pradeepa-s/temperature_logger/README.md

# Temperature Logger

A temperature logger project to start learning fundamentals of product design.

# Tests

## Behavioral

Behavioural tests are implemented for the design and they can be found in tests/behavior folder.

### Setup

1. Install Python 3.6 or above
1. Install behave
1. Install ST-LINK-CLI (comes with STLink utility)
1. Ensure that the ST-LINK-CLI is in the path

### How to run tests?

Run all the tests:

```
behave
```

Run a test with tag @test_tag:

```
behave -t @test_tag
```
