pradeepa-s/temperature_logger/planning/t_logger_v1.md

# Product capabilities

# Product limitations

1. Cannot go into lowest power modes due to the PCBA limitation of not using the wakeup pin
1. Cannot detect low battery
1. Cannot detect or wake up from USB
1. Cannot read from a given address
1. Cannot find out last write address and count
