pradeepa-s/temperature_logger/hardware/altium/temperature_logger/output/BOM/Bill of Materials-temperature_logger.xlsx

Comment | Description | Designator | Digikey_link | Footprint | LibRef | Manufacturer | Manufacturer Part Number | Quantity
 | Header, 2-Pin | BAT, BOOT, USB_POW |  | HDR1X2 | Header 2 |  |  | 3
47 pF | CAP CER 47PF 1KV C0G/NP0 0805 | C100, C101, C211 | https://www.digikey.com.au/product-detail/en/kemet/C0805C470JDGACTU/399-7157-1-ND/3439404 | C0805 | Cap-47pF | KEMET | C0805C470JDGACTU | 3
10 nF | CAP CER 10000PF 10V X7R 0805 | C102, C106 | https://www.digikey.com.au/product-detail/en/wurth-electronics-inc/885012207011/732-8021-1-ND/5454648 | C0805 | Cap-10nF | Wurth Electronics Inc. | 885012207011 | 2
100 nF | CAP CER 0.1UF 50V X7R 0805 | C103, C209 | https://www.digikey.com.au/product-detail/en/kemet/C0805X104K5RACTU/399-5330-1-ND/1842309 | C0805 | Cap-100nF | KEMET | C0805X104K5RACTU | 2
1000 pF | CAP CER 1000PF 100V X7R 0805 | C200, C201, C202, C203, C204, C205, C206, C207, C208, C210 | https://www.digikey.com.au/product-detail/en/kemet/C0805C102K1RACTU/399-1148-2-ND/411147 | C0805 | Cap-1000pF | KEMET | C0805C102K1RACTU | 10
LGR971 | LED GREEN DIFFUSED 0805 SMD | D200 | https://www.digikey.com.au/product-detail/en/osram-opto-semiconductors-inc/LG-R971-KN-1/475-1410-2-ND/1227925 | D0805 | LGR971 | Osram Opto | LG R971-KN-1 | 1
USB_Micro_B | USB - micro B USB 2.0 Receptacle Connector 5 Position Surface Mount, Right Angle; Through Hole | J100 | https://www.digikey.com.au/product-detail/en/te-connectivity-amp-connectors/2040002-1/A108263CT-ND/4021990 | MicroUSB | USB_Micro_B | TE Connectivity | 2040002-1 | 1
MicroSD | MICRO SD PUSH PUSH LOW PROFILE TYPE | J200 | https://www.digikey.com.au/product-detail/en/te-connectivity-amp-connectors/2201778-1/A118117CT-ND/4729820 | MicroSD | MicroSD | TE Connectivity | 2201778-1 | 1
 | Header, 5-Pin | JTAG |  | HDR1X5 | Header 5 |  |  | 1
5 k | RES SMD 4.7K OHM 0.1% 1/8W 0805 | R200, R201, R202 | https://www.digikey.com.au/product-detail/en/panasonic-electronic-components/ERA-6AEB472V/P4.7KDACT-ND/1465963 | R0805 | Res-5k | Panasonic Electronic Components | ERA-6AEB472V | 3
1 k | RES 1K OHM 0.1% 1/5W 0805 | R203, R204, R205, R206, R208, R211 | https://www.digikey.com.au/product-detail/en/vishay-dale/TNPW08051K00BEEA/TNP1.00KABTR-ND/1607282 | R0805 | Res-1k | Vishay Dale | TNPW08051K00BEEA | 6
10 k | RES SMD 10K OHM 0.1% 1/8W 0805 | R207 | https://www.digikey.com/product-detail/en/panasonic-electronic-components/ERA-6AEB103V/P10KDACT-ND/1465971 | R0805 | Res-10k | Panasonic Electronic Components | ERA-6AEB103V | 1
27 | RES SMD 27 OHM 5% 1/8W 0805 | R209, R210 | https://www.digikey.com.au/product-detail/en/panasonic-electronic-components/ERJ-6GEYJ270V/P27ACT-ND/42810 | R0805 | Res-27 | Panasonic Electronic Components | ERJ-6GEYJ270V | 2
Switch_tactile | SWITCH TACTILE SPST-NO 0.05A 12V | S200 | https://www.digikey.com.au/product-detail/en/c-k/PTS645SM43SMTR92-LFS/CKN9112CT-ND/1146934 | Tactile1 | Switch_tactile | C&K Components | PTS645SM43SMTR | 1
STM32L053 | IC MCU 32BIT 64KB FLASH 48LQFP | U200 | https://www.digikey.com.au/product-detail/en/stmicroelectronics/STM32L053C8T6/497-14906-ND/4935255 | LQFP48-7x7mm | STM32L0x3CL4 | STMicroelectronics | STM32L053C8T6 | 1
TMP112 | 1.4V-Capable ?0.5?C Temperature Sensor with Alert Function and I2C/SMBus interface in SOT-563 6-SOT -40 to 125 | U201 | https://www.digikey.com/product-detail/en/texas-instruments/TMP112AIDRLR/296-38578-2-ND/2232593 | SOT563 | TMP112AIDRLT | Texas Instruments | TMP112AIDRLT | 1
16MB_FLASH | IC FLASH 16M SPI 80MHZ 8SOP | U202 | https://www.digikey.com/product-detail/en/macronix/MX25R1635FM2IH1/1092-1176-ND/5957737 | 8-SOIC | MX25R1635 | Macronix | MX25R1635FM2IL0 | 1
FT231XS-R | USB Full Speed to Full Handshake UART with USB Charger Detection | U203 | https://www.digikey.com/product-detail/en/ftdi-future-technology-devices-international-ltd/FT231XS-R/768-1129-1-ND/3029151 | SSOP20 | FT231XS-R | FTDI | FT231XS-R | 1
