pradeepa-s/temperature_logger/hardware/kicad/temperature_logger/micro-usb-b-female-5pin-smd-1.snapshot.2/Micro USB-B Female 5Pin SMD.STEP

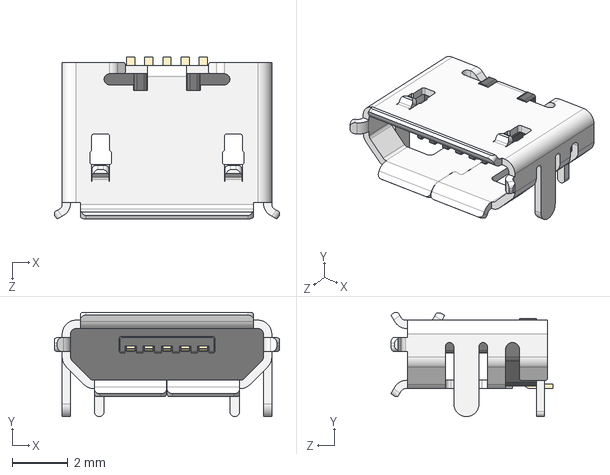
[picture p1: CAD file, 2021-06-26]
hardware/kicad/temperature_logger/micro-usb-b-female-5pin-smd-1.snapshot.2/Micro USB-B Female 5Pin SMD.STEP
8.05 x 3.73 x 5.80 mm
