pradeepa-s/temperature_logger/hardware/kicad/temperature_logger/sop8-1.snapshot.1/sop8.STEP

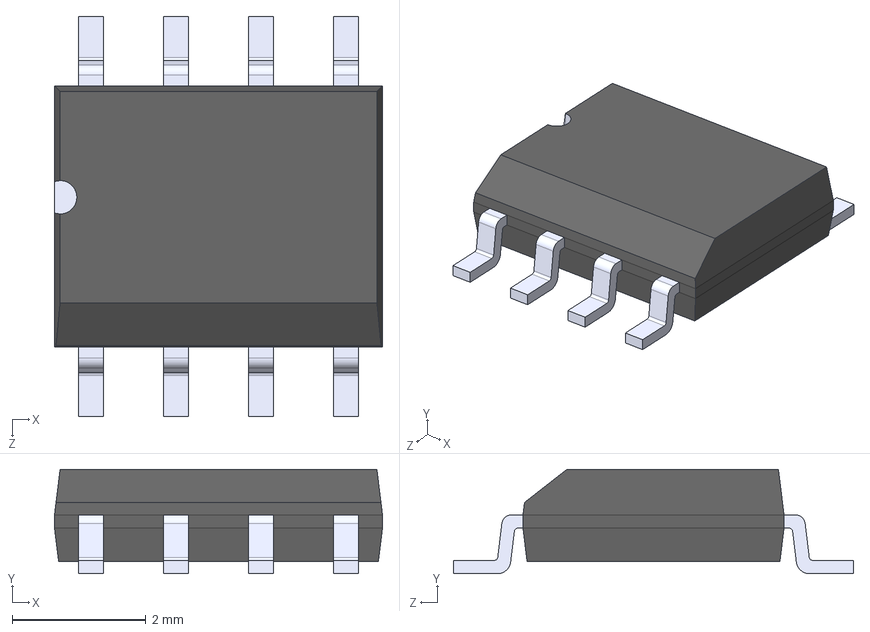
[picture p2: CAD file, 2021-06-26]
hardware/kicad/temperature_logger/sop8-1.snapshot.1/sop8.STEP
4.90 x 1.56 x 5.98 mm
User Library-sop8_model_pin5to8_sop8 x 8
User Library-sop8_model_sop8_body
