pradeepa-s/temperature_logger/hardware/kicad/temperature_logger/tactile-switch-smd-6mm-series-1.snapshot.2/Tactal Switch - SMD (6mmx 6mmx 12mm) - Marked.stp

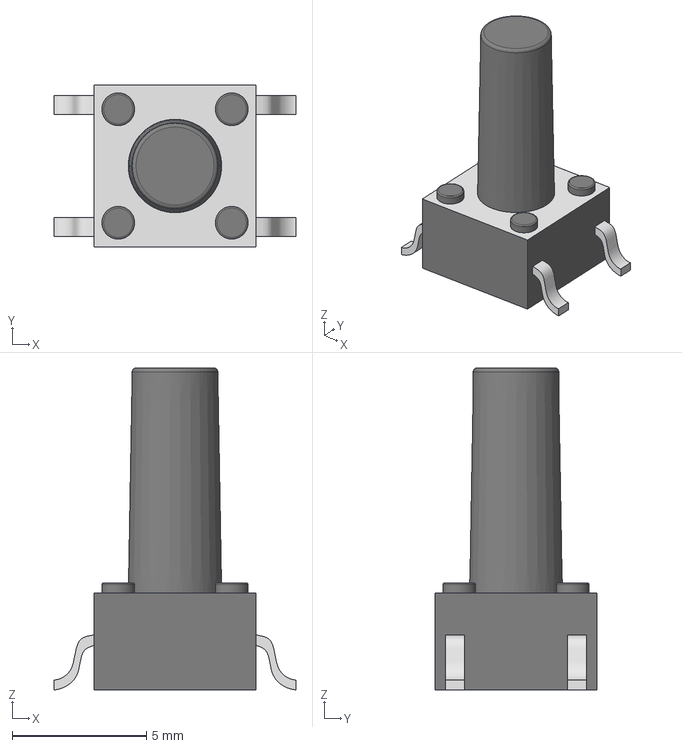
[picture p3: CAD file, 2021-06-26]
hardware/kicad/temperature_logger/tactile-switch-smd-6mm-series-1.snapshot.2/Tactal Switch - SMD (6mmx 6mmx 12mm) - Marked.stp
9.02 x 6.03 x 12.0 mm
