pradeepa-s/temperature_logger/(list of files, cad)

Other CAD files:
hardware/kicad/temperature_logger/micro-usb-b-female-5pin-smd-1.snapshot.2/Micro USB-B Female 5Pin SMD.x_b
