pradeepa-s/temperature_logger/uart_test.gif

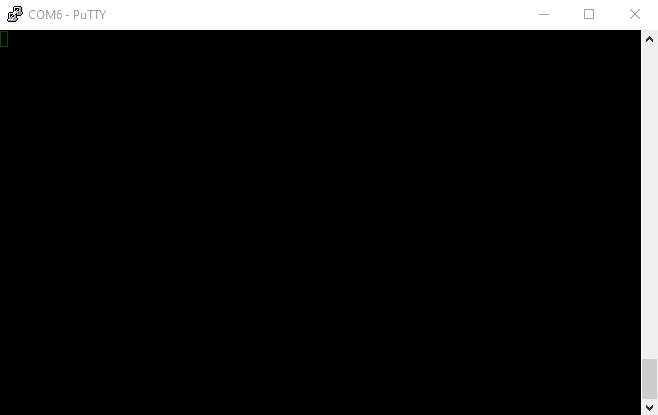
uart_test.gif
