pradeepa-s/temperature_logger/hardware/altium/temperature_logger/temperature_logger.pdf

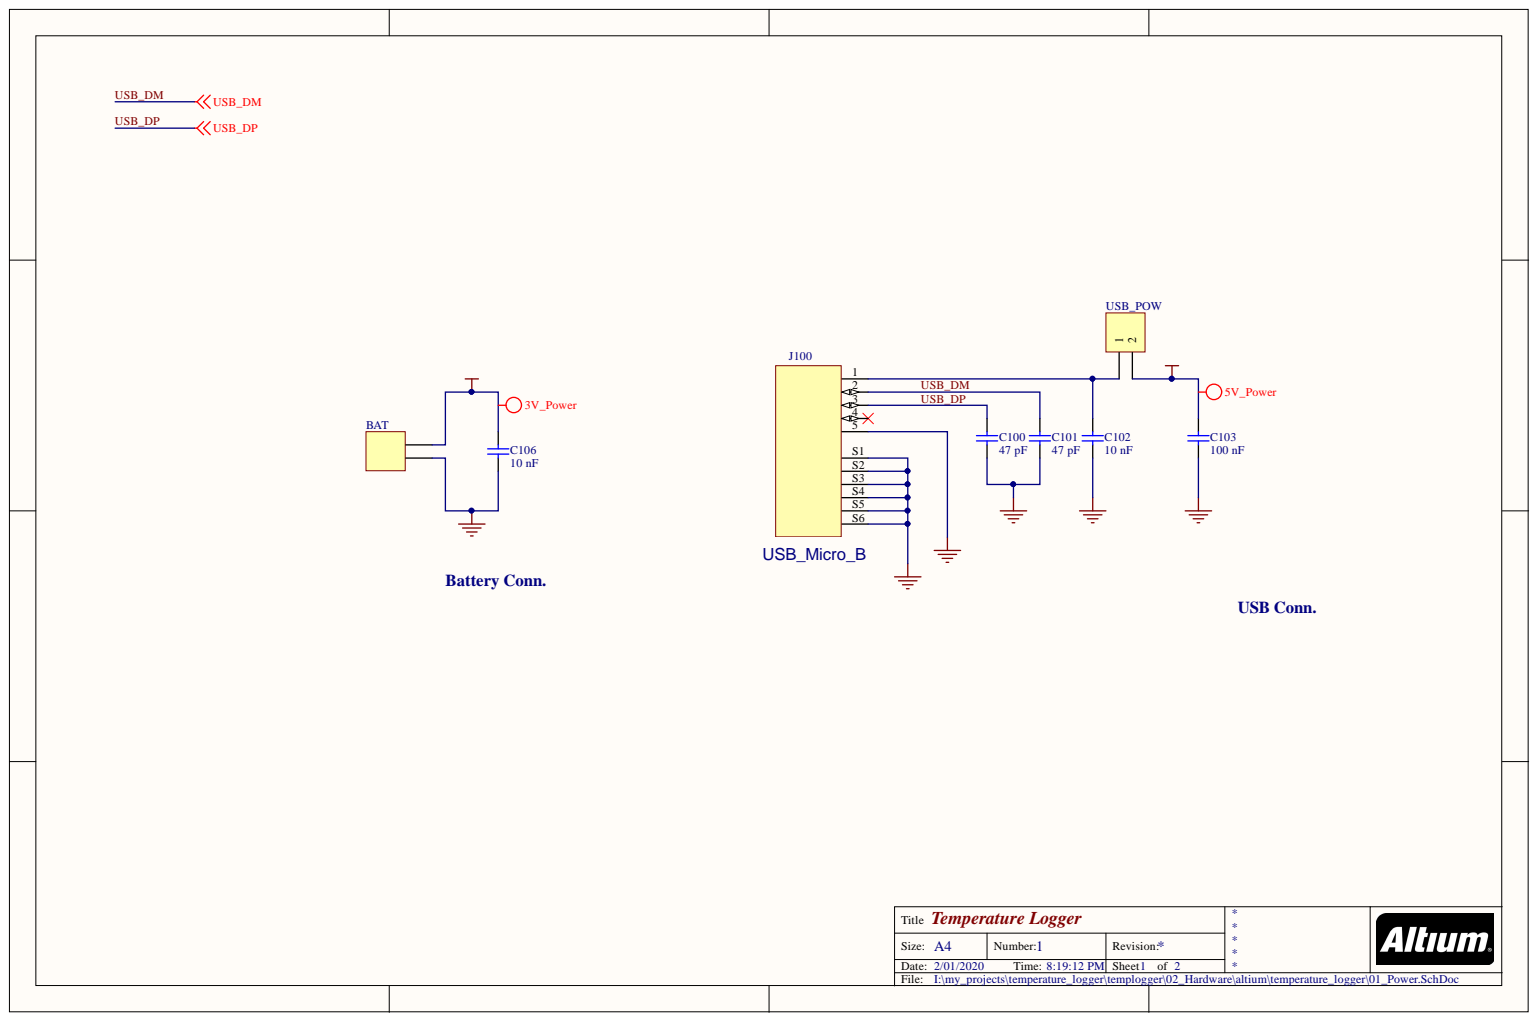
[picture p13: page 1]

Temperature Lo gger T i t l e | **** *

Size: A4 | N umber: 1 | Rev i s i o n : *
Date: 2 / 0 1 / 2 0 2 0 T ime: 8 : 1 9 : 1 2 PM | | Sheet 1 o f 2

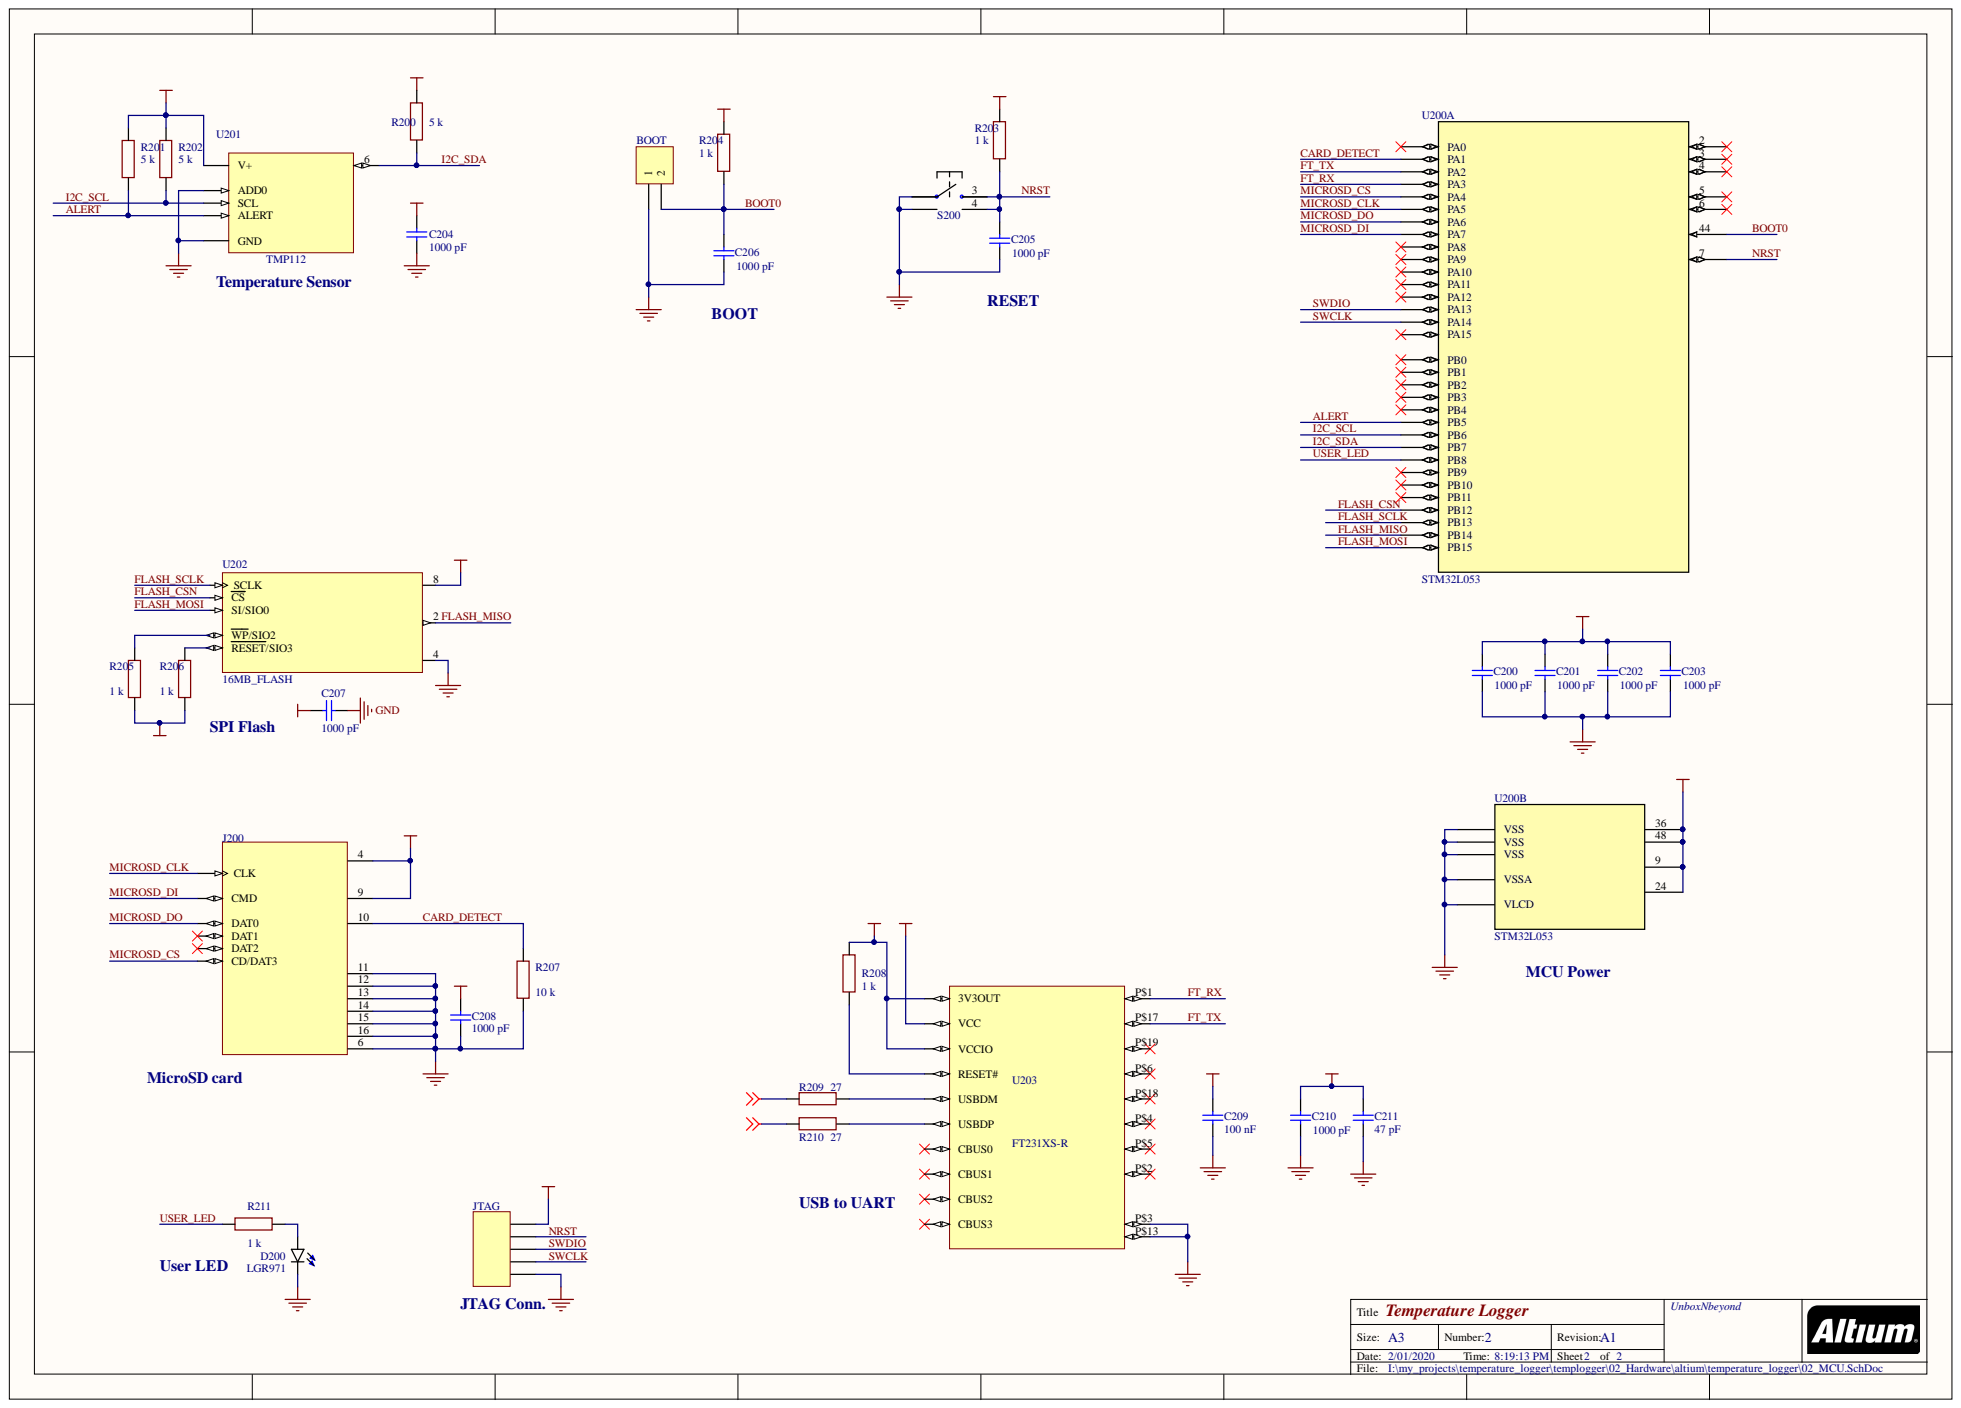
[picture p14: page 2]

Temperature Logger Title | UnboxNbeyond

Size: A3 | Number: 2 | Revision: A1
Date: 2/01/2020 Time: 8:19:13 PM | | Sheet 2 of 2

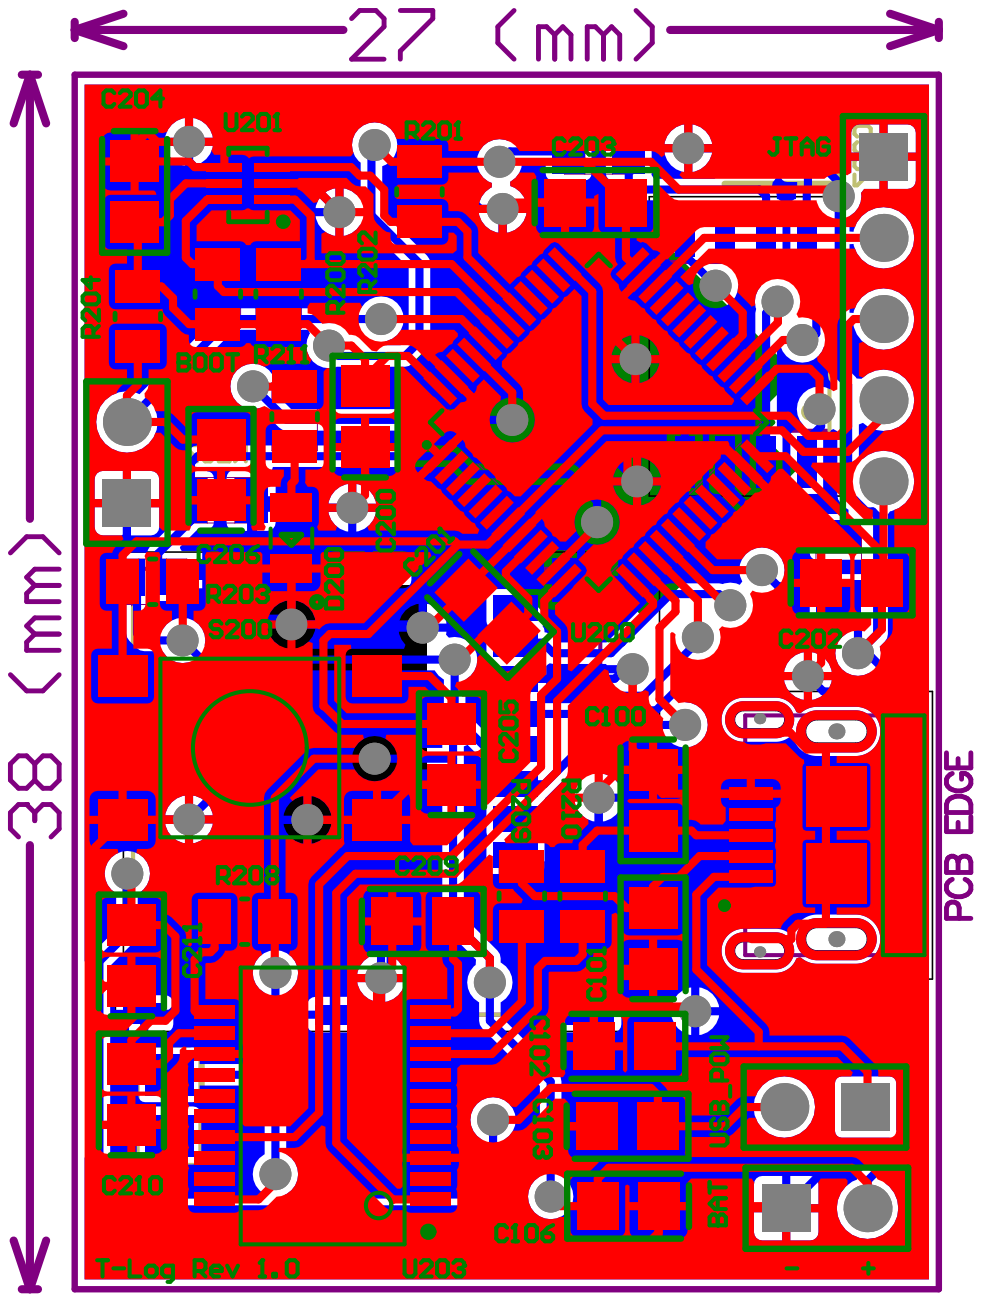
[picture p15: page 3]
