pradeepa-s/temperature_logger/(list of files, drawings)

Other design files:
hardware/altium/temperature_logger/01_Power.SchDoc
hardware/altium/temperature_logger/02_MCU.SchDoc
hardware/altium/temperature_logger/temperature_logger.PrjPcb
hardware/altium/temperature_logger/temperature_logger_pcb.PcbDoc
hardware/altium/temperature_logger/temperature_logger_pcb_v1.PcbDoc
hardware/altium/temperature_logger/temperature_logger_pcb_v2.PcbDoc
hardware/altium/temperature_logger/temperature_logger_pcb_v3.PcbDoc
