pradeepa-s/temperature_logger/hardware/kicad/temperature_logger/temperature_logger.kicad_pcb

## KiCad design hardware/kicad/temperature_logger/temperature_logger.kicad_pcb (2023-07-01)

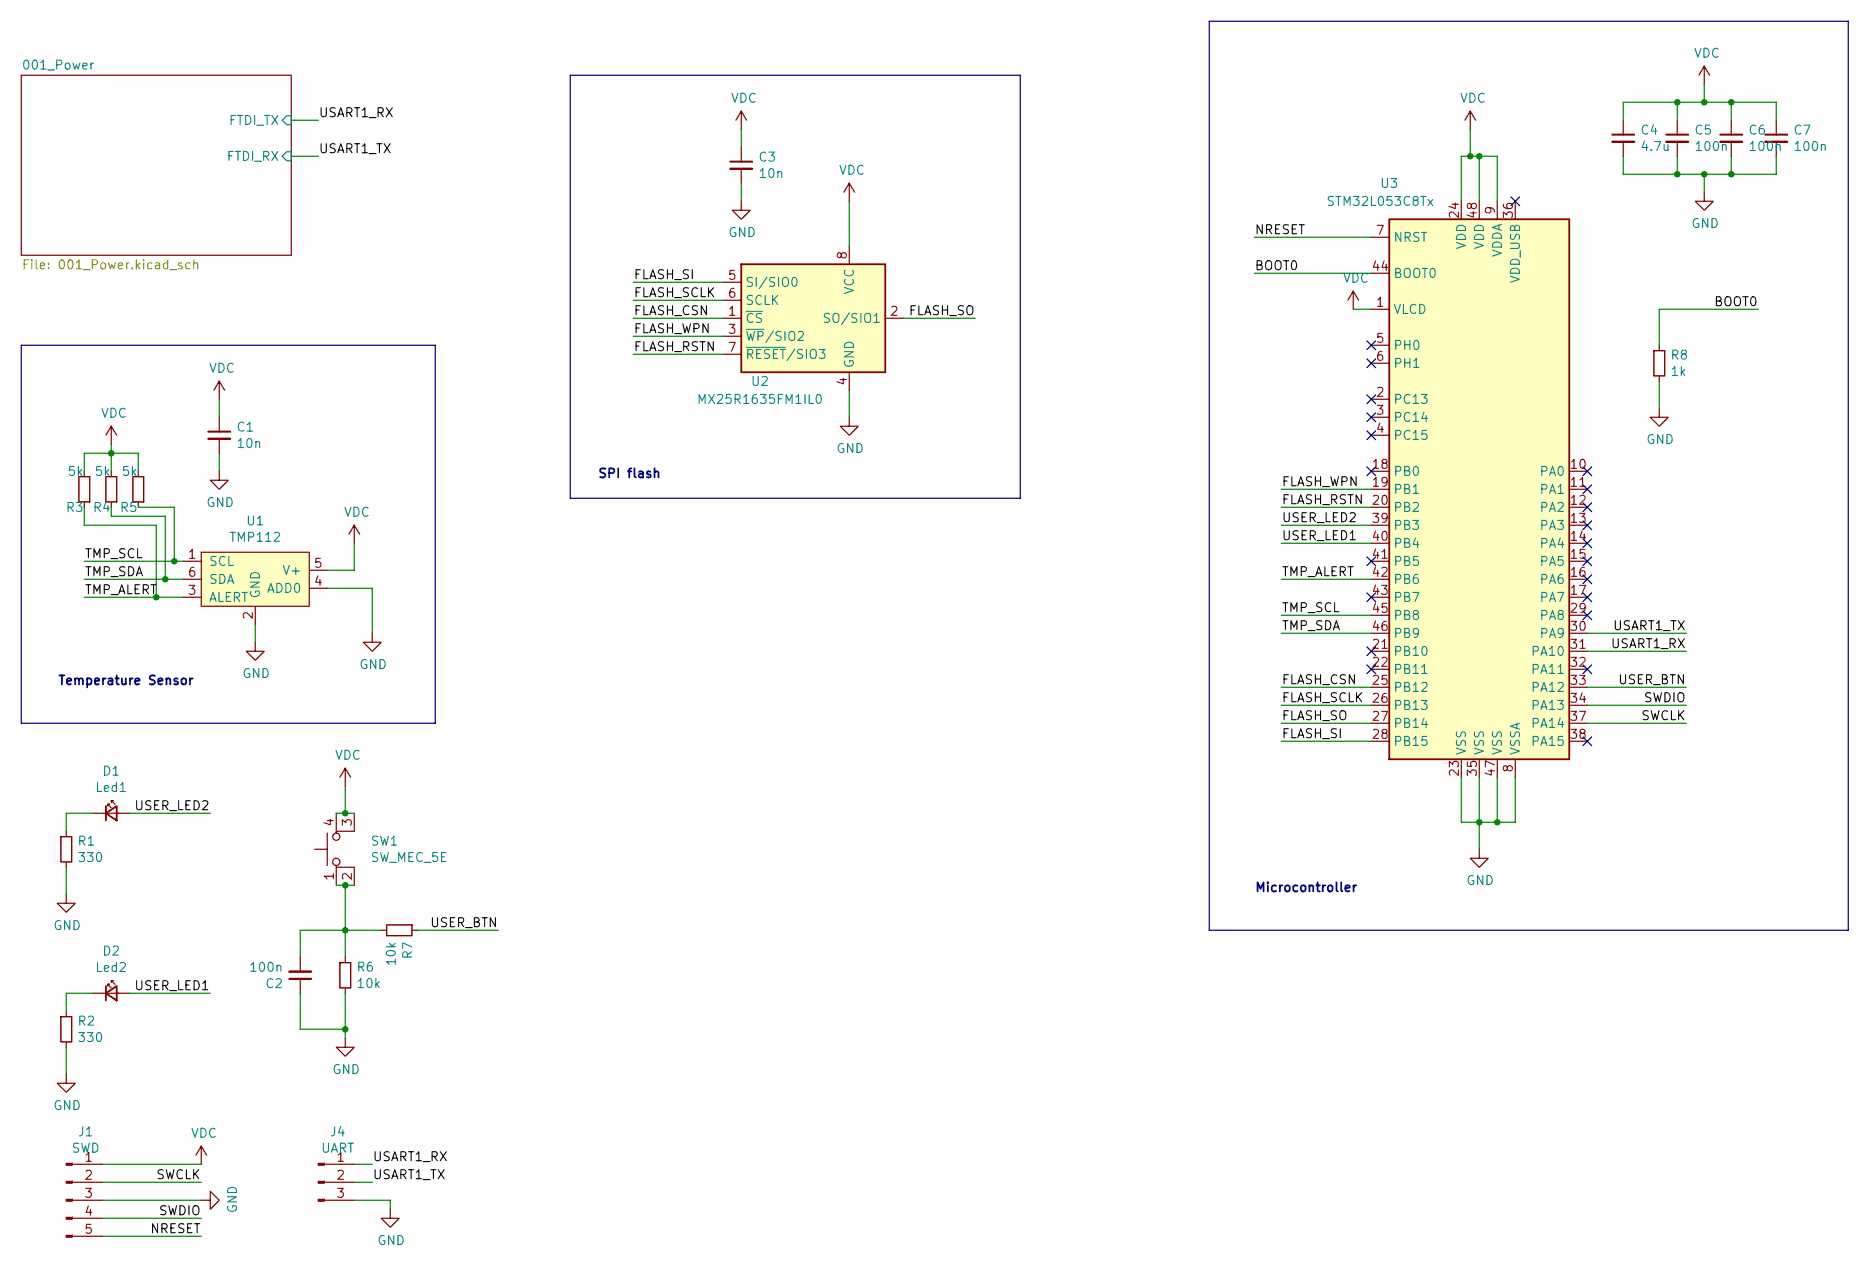
[picture p16: schematic temperature_logger.kicad_sch, Temperature Logger]

Parts:
C1, C3: 10n; C_0603_1608Metric_Pad1.08x0.95mm_HandSolder
C2, C5, C6, C7: 100n; C_0603_1608Metric_Pad1.08x0.95mm_HandSolder
C4: 4.7u; C_0603_1608Metric_Pad1.08x0.95mm_HandSolder
D1: Led1; LED_0603_1608Metric_Pad1.05x0.95mm_HandSolder
D2: Led2; LED_0603_1608Metric_Pad1.05x0.95mm_HandSolder
J1: SWD; PinHeader_1x05_P2.54mm_Vertical
J4: UART; PinHeader_1x03_P2.54mm_Vertical
R1, R2: 330; R_0603_1608Metric_Pad1.05x0.95mm_HandSolder
R3, R4, R5: 5k; R_0603_1608Metric_Pad1.05x0.95mm_HandSolder
R6, R7: 10k; R_0603_1608Metric_Pad1.05x0.95mm_HandSolder
R8: 1k; R_0603_1608Metric_Pad1.05x0.95mm_HandSolder
SW1: SW_MEC_5E; SW_SPST_Omron_B3FS-101xP
U1: TMP112; SOT-666
U2: MX25R1635FM1IL0; SOP-8_3.9x4.9mm_P1.27mm
U3: STM32L053C8Tx; LQFP-48_7x7mm_P0.5mm

Connections:
/BOOT0: R8.1, U3.44 (BOOT0)
/FLASH_CSN: U2.1 (~CS), U3.25 (PB12)
/FLASH_RSTN: U2.7 (~RESET/SIO3), U3.20 (PB2)
/FLASH_SCLK: U2.6 (SCLK), U3.26 (PB13)
/FLASH_SI: U2.5 (SI/SIO0), U3.28 (PB15)
/FLASH_SO: U2.2 (SO/SIO1), U3.27 (PB14)
/FLASH_WPN: U2.3 (~WP/SIO2), U3.19 (PB1)
/NRESET: J1.5, U3.7 (NRST)
/SWCLK: J1.2, U3.37 (PA14)
/SWDIO: J1.4, U3.34 (PA13)
/TMP_ALERT: R3.1, U1.3 (ALERT), U3.42 (PB6)
/TMP_SCL: R5.1, U1.1 (SCL), U3.45 (PB8)
/TMP_SDA: R4.1, U1.6 (SDA), U3.46 (PB9)
/USART1_RX: J4.1, U3.31 (PA10); also elsewhere on the board
/USART1_TX: J4.2, U3.30 (PA9); also elsewhere on the board
/USER_BTN: R7.1, U3.33 (PA12)
/USER_LED1: D2.2 (A), U3.40 (PB4)
/USER_LED2: D1.2 (A), U3.39 (PB3)
GND: C1.2, C2.1, C3.2, C4.2, C5.2, C6.2, C7.2, J1.3, J4.3, R1.2, R2.2, R6.2, R8.2, U1.2 (GND), U1.4 (ADD0), U2.4 (GND), U3.8 (VSSA), U3.23 (VSS), U3.35 (VSS), U3.47 (VSS); also elsewhere on the board
unnamed: C2.2, R6.1, R7.2, SW1.1, SW1.2
unnamed: D1.1 (K), R1.1
unnamed: D2.1 (K), R2.1
VDC: C1.1, C3.1, C4.1, C5.1, C6.1, C7.1, J1.1, R3.2, R4.2, R5.2, SW1.3 (K), SW1.4 (A), U1.5 (V+), U2.8 (VCC), U3.1 (VLCD), U3.9 (VDDA), U3.24 (VDD), U3.48 (VDD); also elsewhere on the board

Notes on the sheet:
Microcontroller
SPI flash
Temperature Sensor

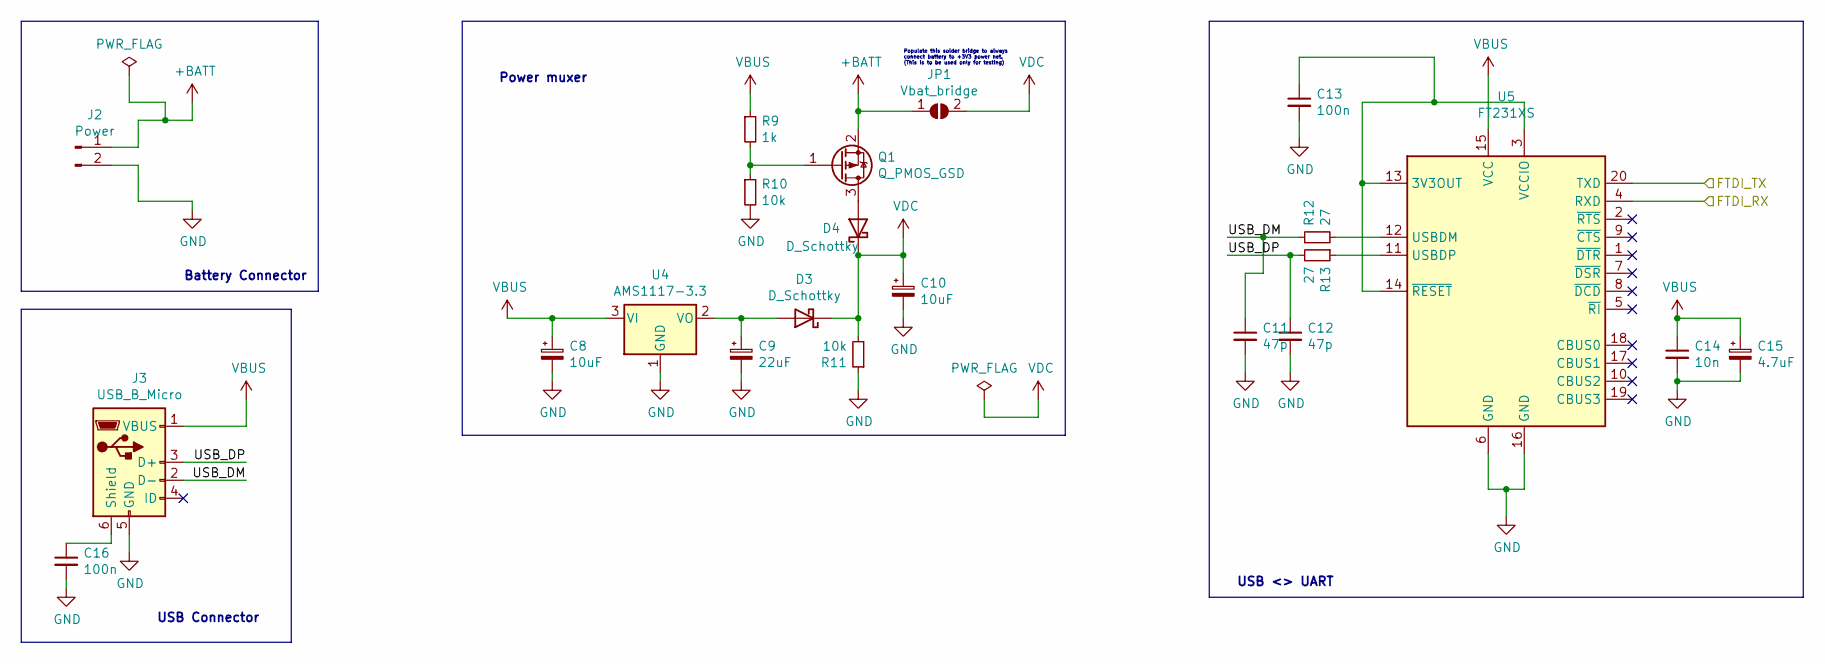
[picture p17: schematic 001_Power.kicad_sch, Temperature Logger]

Parts:
C8, C10: 10uF; CP_Elec_4x5.7
C9: 22uF; CP_Elec_4x5.7
C11, C12: 47p; C_0603_1608Metric_Pad1.08x0.95mm_HandSolder
C13, C16: 100n; C_0603_1608Metric_Pad1.08x0.95mm_HandSolder
C14: 10n; C_0603_1608Metric_Pad1.08x0.95mm_HandSolder
C15: 4.7uF; CP_Elec_4x5.7
D3, D4: D_Schottky; D_SOD-323_HandSoldering
J2: Power; BatteryHolder_Keystone_1060_1x2032
J3: USB_B_Micro; USB_Micro-B_Molex-105017-0001
JP1: Vbat_bridge; R_0603_1608Metric
Q1: Q_PMOS_GSD; SOT-23
R9: 1k; R_0603_1608Metric_Pad1.05x0.95mm_HandSolder
R10, R11: 10k; R_0603_1608Metric_Pad1.05x0.95mm_HandSolder
R12, R13: 27; R_0603_1608Metric_Pad1.05x0.95mm_HandSolder
U4: AMS1117-3.3; SOT-223-3_TabPin2
U5: FT231XS; SSOP-20_3.9x8.7mm_P0.635mm

Connections:
+BATT: J2.1, JP1.1 (A), Q1.2 (S)
/001_Power/USB_DM: C11.1, J3.2 (D-), R12.1
/001_Power/USB_DP: C12.1, J3.3 (D+), R13.2
/USART1_RX: U5.20 (TXD); also elsewhere on the board
/USART1_TX: U5.4 (RXD); also elsewhere on the board
GND: C8.2, C9.2, C10.2, C11.2, C12.2, C13.2, C14.2, C15.2, C16.2, J2.2, J3.5 (GND), R10.2, R11.1, U4.1 (GND), U5.6 (GND), U5.16 (GND); also elsewhere on the board
unnamed: C13.1, U5.3 (VCCIO), U5.13 (3V3OUT), U5.14 (~RESET)
unnamed: C16.1, J3.6 (Shield)
unnamed: C9.1, D3.2 (A), U4.2 (VO)
unnamed: D4.2 (A), Q1.3 (D)
unnamed: Q1.1 (G), R9.2, R10.1
unnamed: R12.2, U5.12 (USBDM)
unnamed: R13.1, U5.11 (USBDP)
VBUS: C8.1, C14.1, C15.1, J3.1 (VBUS), R9.1, U4.3 (VI), U5.15 (VCC)
VDC: C10.1, D3.1 (K), D4.1 (K), JP1.2 (B), R11.2; also elsewhere on the board

Notes on the sheet:
Battery Connector
USB Connector
Populate this solder bridge to always connect battery to +3V3 power net. (This is to be used only for testing)
Power muxer
USB <> UART

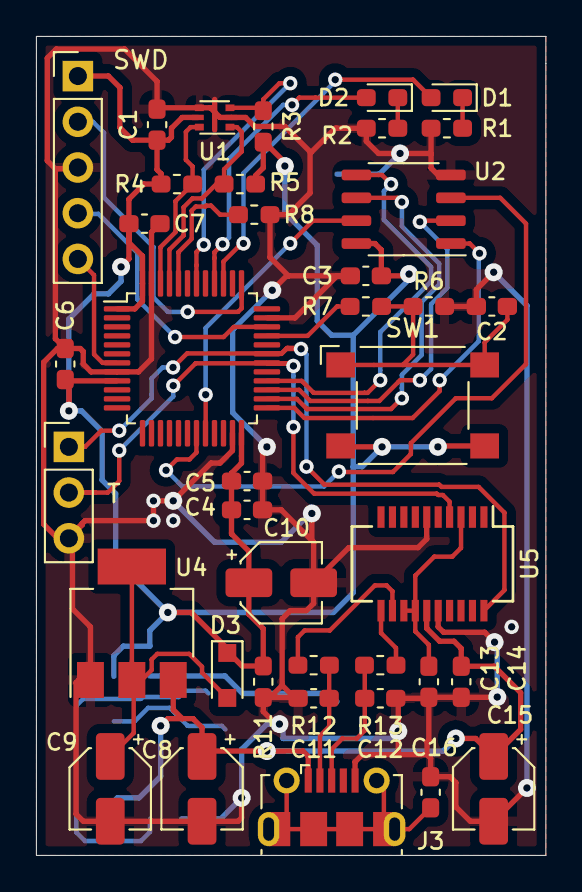
[picture p18: board temperature_logger.kicad_pcb from above]

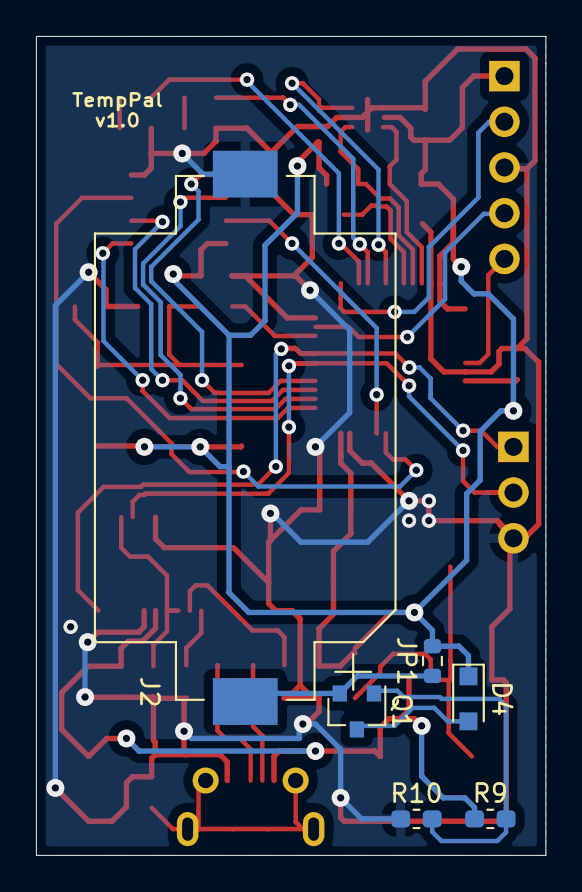
[picture p19: board temperature_logger.kicad_pcb from below]

Board: 2 copper layers, 28.3 x 45.5 mm, 45 parts (6 on the bottom side), 34 nets.
