pradeepa-s/temperature_logger/firmware/temperature_logger_fw/Core/Src/main.c

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
/* Includes ------------------------------------------------------------------*/
#include "main.h"
#include "i2c.h"
#include "rtc.h"
#include "spi.h"
#include "tim.h"
#include "usart.h"
#include "gpio.h"

/* USER CODE BEGIN Includes */
#include <stdlib.h>
#include <stdio.h>
#include "event_manager.h"
#include "button.h"
#include "storage_controller.h"
#include "pc_comms.h"
#include "dev_time.h"
#include "tmp112_sensor.h"
#include "dev_led.h"
#include "dev_operation_tracker.h"
/* USER CODE END Includes */


/* USER CODE BEGIN PV */
uint8_t is_in_config = 0;
/* USER CODE END PV */

void SystemClock_Config(void);
/* USER CODE BEGIN PFP */
void log_temperature();
void chip_read();
void chip_erase();
void update_time();
void get_state();
void change_alarm();
void indicate_alarm();
void tmp112_i2c_tx_func(uint8_t address, uint8_t* data, size_t size);
void tmp112_i2c_rx_func(uint8_t address, uint8_t* read_data, size_t size);
/* USER CODE END PFP */

/* USER CODE BEGIN 0 */
void HAL_GPIO_EXTI_Callback(uint16_t GPIO_Pin)
{
	process_button_event();
}

void HAL_TIM_PeriodElapsedCallback(TIM_HandleTypeDef *htim)
{
	if (htim == &htim2)
	{
		dev_led_low_done();
	}
}

void HAL_TIM_OC_DelayElapsedCallback(TIM_HandleTypeDef *htim)
{
	if (htim == &htim21 && htim->Channel == HAL_TIM_ACTIVE_CHANNEL_1)
	{
		button_press_and_hold();
	}
	else if(htim == &htim2 && htim->Channel == HAL_TIM_ACTIVE_CHANNEL_1)
	{
		dev_led_high_done();
	}
}

void HAL_RTC_AlarmAEventCallback(RTC_HandleTypeDef *hrtc)
{
    rtc_alarm_elapsed();
}

void HAL_UART_RxCpltCallback(UART_HandleTypeDef *huart)
{
	data_received_from_pc();
}
/* USER CODE END 0 */

/**
  * @brief  The application entry point.
  * @retval int
  */
int main(void)
{
  /* MCU Configuration--------------------------------------------------------*/

  /* Reset of all peripherals, Initializes the Flash interface and the Systick. */
  HAL_Init();

  /* Configure the system clock */
  SystemClock_Config();

  /* Initialize all configured peripherals */
  MX_GPIO_Init();
  MX_TIM2_Init();
  MX_SPI2_Init();
  MX_USART1_UART_Init();
  MX_RTC_Init();
  MX_I2C1_Init();
  MX_TIM21_Init();
  /* USER CODE BEGIN 2 */

  tmp112_sensor_init(0x48, tmp112_i2c_tx_func, tmp112_i2c_rx_func);
  button_init(submit_event);
  dev_time_init(submit_event);
  pc_comms_init(submit_event);
  /* USER CODE END 2 */

  /* Infinite loop */
  /* USER CODE BEGIN WHILE */
  uint8_t was_in_config = is_in_config;

#ifdef STARTUP_TEST
  for (int i = 0; i < 12; i++)
  {
	  HAL_GPIO_TogglePin(GPIOB, GPIO_PIN_3);
	  HAL_GPIO_TogglePin(GPIOB, GPIO_PIN_4);
	  HAL_Delay(250);
  }

  HAL_GPIO_WritePin(GPIOB, GPIO_PIN_3, GPIO_PIN_SET);
  while(1)
  {
	  HAL_GPIO_TogglePin(GPIOB, GPIO_PIN_3);
	  HAL_GPIO_TogglePin(GPIOB, GPIO_PIN_4);
	  HAL_Delay(1000);
  }
#endif

#ifdef PRINT_TIME
  while(1)
  {
	  Timestamp ts;
	  get_timestamp(&ts);
	  HAL_UART_Transmit(&huart1, ts.buffer, sizeof(ts.buffer), 0xFFFFFFFF);
	  HAL_Delay(1000);
  }
#endif

#ifdef STORAGE_READ_WRITE
  {
	  flash_storage_erase_full();

	  storage_entry se;
	  se.dt.year = 2022;
	  se.dt.month = 11;
	  se.dt.date = 18;
	  se.dt.hour = 21;

	  // Create 1000 dummy data items
	  for (int i = 0; i < 100; i++)
	  {
		  se.tr = i % 50;
		  se.dt.minute = i / 60;
		  se.dt.seconds = i % 60;
		  flash_storage_write(&se, 1);
	  }

	  int turn = 0;
	  while (1)
	  {
		  int count = flash_storage_read(&se, 1);

		  if (count)
		  {
			  const datetime* dt = &(se.dt);

			  char reading[34] = {0};
			  snprintf(reading, sizeof(reading), "\r\n[%04d].%04d:%02d:%02d:%02d:%02d:%02d:%04d",
					turn, dt->year, dt->month, dt->date, dt->hour, dt->minute, dt->seconds,
					se.tr);
			  HAL_UART_Transmit(&huart1, (uint8_t*)reading, sizeof(reading), 0xFFFFFFFF);
			  turn++;
			  HAL_Delay(200);
		  }
		  else
		  {
			  while(1);
		  }
	  }
  }
#endif


  // TODO: Find next write address
  storage_controller_init();

  HAL_DBGMCU_EnableDBGStopMode();

  while (1)
  {
      event_id ev = get_next_event();

	  if (!is_in_config && DEVICE_EVENT_NONE == ev && !dev_operation_is_pending())
	  {
		  HAL_SuspendTick();
		  __HAL_PWR_CLEAR_FLAG(PWR_FLAG_WU);
		  HAL_PWR_EnterSTOPMode(PWR_LOWPOWERREGULATOR_ON, PWR_STOPENTRY_WFI);

		  SystemClock_Config();
		  ev = get_next_event();
	  }

      switch(ev)
      {
          case DEVICE_EVENT_RTC_ALARM_ELAPSED:
              log_temperature();
              break;

          case DEVICE_EVENT_CHIP_READ:
              if (is_in_config)
              {
            	  chip_read();
              }
              break;

          case DEVICE_EVENT_LONG_BUTTON_PRESS:
              is_in_config = ~is_in_config;
              break;

          case DEVICE_EVENT_CHIP_ERASE:
              if (is_in_config)
              {
            	  // TODO:
            	  // stop logging
                  chip_erase();
                  // start logging
              }
              else
              {
            	  // TODO: Send error
              }
              break;

          case DEVICE_EVENT_UPDATE_TIME:
              if (is_in_config)
              {
            	  update_time();
              }
              break;

          case DEVICE_EVENT_GET_STATE:
              if (is_in_config)
              {
            	  get_state();
              }
              break;

          case DEVICE_EVENT_SINGLE_BUTTON_PRESS:
              if (is_in_config)
              {
                  change_alarm();
              }
              else
              {
                  indicate_alarm();
              }
              break;

          default:
              break;
      }

	  if (is_in_config != was_in_config)
	  {
		  char done[] = "<<M";
		  HAL_UART_Transmit(&huart1, (uint8_t*)done, sizeof(done), 0xFFFFFFFF);
          indicate_alarm();
		  was_in_config = is_in_config;

		  if (is_in_config)
		  {
			  HAL_GPIO_WritePin(LED_BLUE_GPIO_Port, LED_BLUE_Pin, GPIO_PIN_SET);
		  }
		  else
		  {
			  HAL_GPIO_WritePin(LED_BLUE_GPIO_Port, LED_BLUE_Pin, GPIO_PIN_RESET);
		  }
	  }

      complete_event(ev);
    /* USER CODE END WHILE */

    /* USER CODE BEGIN 3 */
  }
  /* USER CODE END 3 */
}

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
/* USER CODE BEGIN 4 */
void log_temperature()
{
    //char done[] = "<<L";
    //HAL_UART_Transmit(&huart1, (uint8_t*)done, sizeof(done), 0xFFFFFFFF);
	storage_entry se;
    set_next_alarm();
    double true_temp = tmp112_sensor_get_temperature();
    se.tr = true_temp * 10000;
    get_datetime(&(se.dt));
    flash_storage_write(&se, 1);
}

void chip_read()
{
    flash_storage_read_start();

    int read_index = 0;
    while (1)
    {
		storage_entry se;

		int count = flash_storage_read(&se, 1);

		if (count)
		{
		  const datetime* dt = &(se.dt);

		  char reading[34] = {0};
		  snprintf(reading, sizeof(reading), "\r\n[%04d].%04d:%02d:%02d:%02d:%02d:%02d:%04d",
				  read_index, dt->year, dt->month, dt->date, dt->hour, dt->minute, dt->second,
				se.tr);
		  HAL_UART_Transmit(&huart1, (uint8_t*)reading, sizeof(reading), 0xFFFFFFFF);
		  ++read_index;
		  HAL_Delay(50);
		}
		else
		{
		  return;
		}
	}
}

void chip_erase()
{
	flash_storage_erase_full();
    char done[] = "<<E";
    HAL_UART_Transmit(&huart1, (uint8_t*)done, sizeof(done), 0xFFFFFFFF);
}

void update_time()
{
    dev_time_set(pc_comms_yy, pc_comms_mm, pc_comms_dd, pc_comms_hh, pc_comms_min, pc_comms_ss);
    char done[] = "<<T";
    HAL_UART_Transmit(&huart1, (uint8_t*)done, sizeof(done), 0xFFFFFFFF);
}

void get_state()
{
	datetime dt;
    double true_temp = tmp112_sensor_get_temperature();
    temperature tr = true_temp * 10000;
    get_datetime(&dt);
    char status[27] = {0};
	snprintf(status, sizeof(status), "%04d:%02d:%02d:%02d:%02d:%02d:%04d\r\n",
		  dt.year, dt.month, dt.date, dt.hour, dt.minute, dt.second, tr);
    HAL_UART_Transmit(&huart1, (uint8_t*)status, sizeof(status), 0xFFFFFFFF);
}

void change_alarm()
{
    dev_time_alarm_change();
    indicate_alarm();
}

void indicate_alarm()
{
    uint8_t alarm = dev_time_get_alarm();
    dev_led_indicate_alarm(alarm);
    dev_operation_complete(DEV_OPERATION_BUTTON);
}

void tmp112_i2c_tx_func(uint8_t address, uint8_t* data, size_t size)
{
	HAL_I2C_Master_Transmit(&hi2c1, (address << 1), data, size, 0xffffffff);
}

void tmp112_i2c_rx_func(uint8_t address, uint8_t* read_data, size_t size)
{
	HAL_I2C_Master_Receive(&hi2c1, (address << 1), read_data, size, 0xffffffff);
}
/* USER CODE END 4 */
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
