pradeepa-s/temperature_logger/firmware/temperature_logger_fw/temperature_logger_fw.ioc

Mcu.UserName=STM32L053C8Tx
PA10.Signal=USART1_RX
PA12.GPIO_Label=USER_BUTTON
PA12.Signal=GPXTI12
PA13.Signal=SYS_SWDIO
PA14.Signal=SYS_SWCLK
PA9.Signal=USART1_TX
PB12.GPIO_Label=SPI_CSN
PB12.Signal=GPIO_Output
PB13.Signal=SPI2_SCK
PB14.Signal=SPI2_MISO
PB15.Signal=SPI2_MOSI
PB3.GPIO_Label=LED_GREEN
PB3.Signal=GPIO_Output
PB4.GPIO_Label=LED_BLUE
PB4.Signal=GPIO_Output
PB8.Signal=I2C1_SCL
PB9.Signal=I2C1_SDA
