pradeepa-s/temperature_logger/firmware/temperature_logger/Core/Inc/main.h

#define FLASH_NCS_Pin GPIO_PIN_12
#define FLASH_NCS_GPIO_Port GPIOB
#define FLASH_SCK_Pin GPIO_PIN_13
#define FLASH_SCK_GPIO_Port GPIOB
#define FLASH_MISO_Pin GPIO_PIN_14
#define FLASH_MISO_GPIO_Port GPIOB
#define FLASH_MOSI_Pin GPIO_PIN_15
#define FLASH_MOSI_GPIO_Port GPIOB
