pradeepa-s/temperature_logger/firmware/temperature_logger/Core/Inc/command_defs.h

/*
 * command_defs.h
 *
 *  Created on: Feb 19, 2024
 *      Author: prade
 */

#ifndef INC_COMMAND_DEFS_H_
#define INC_COMMAND_DEFS_H_

// Command codes
#define GET_STATUS_CMD (0x00)
#define SET_DATETIME_CMD (0x01)
#define CHIP_ERASE_CMD (0x02)

// Error codes
#define NO_ERROR (0x00)
#define INVALID_PARAMETERS (0x01)

#endif /* INC_COMMAND_DEFS_H_ */
