pradeepa-s/temperature_logger/firmware/temperature_logger/Core/Inc/storage_manager.h

/*
 * storage_manager.h
 *
 *  Created on: Jan 27, 2024
 *      Author: prade
 */

#ifndef INC_STORAGE_MANAGER_H_
#define INC_STORAGE_MANAGER_H_

void sm_chip_erase();

#endif /* INC_STORAGE_MANAGER_H_ */
