pradeepa-s/temperature_logger/(commit log)

2017-11-26 Added the error handler to blink red led
    [main.c]
2017-11-26 Added UART
2017-11-26 Added printf support
2017-11-26 Added RTC interrupt to display time and set alarm
2020-10-21 Added altium files
    [01_Power.SchDoc, 02_MCU.SchDoc, Bill of Materials-temperature_logger.xlsx, temperature_logger.PrjPcb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]
2021-06-23 Half way through the PCB
    [001_Power.sch, 002_Data_Storaged.sch, temperature_logger.kicad_pcb, temperature_logger.sch, temperature_logger_v1.kicad_pcb]
2021-06-26 Main rounting done for pass 2
    [Micro USB-B Female 5Pin SMD.STEP, Micro USB-B Female 5Pin SMD.x_b, Tactal Switch - SMD (6mmx 6mmx 10mm) - Marked.stp, Tactal Switch - SMD (6mmx 6mmx 11mm) - Marked.stp, Tactal Switch - SMD (6mmx 6mmx 12mm) - Marked.stp, Tactal Switch - SMD (6mmx 6mmx 4.3mm) - Marked.stp, Tactal Switch - SMD (6mmx 6mmx 5mm) - Marked.stp, Tactal Switch - SMD (6mmx 6mmx 6mm) - Marked.stp]
2021-07-24 Hardware routing completed (verification required)
    [001_Power.sch, 002_Data_Storaged.sch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]
2021-08-13 Implemented the single button press logic
    [001_Power.sch]
2021-08-28 integrated the temperature sensor
2021-09-04 Added low power mode and refactored the code
2021-09-12 Added schematic changes
    [001_Power.sch, temperature_logger.sch]
2022-12-06 Temperature logging and RTC is working
2022-12-14 Fixed button bug
2023-07-01 Extracted footprints and schematics
    [001_Power.kicad_sch, temperature_logger.kicad_pcb, temperature_logger.kicad_sch]
2023-07-01 TLV-8: Blinking LED
2023-07-01 TLV-8: Minimal debug printf
2023-07-03 TLV-8: Day 3 implementing debug printf
2023-07-11 TLV-8: Implemented debug printf support
2023-07-18 TLV-9: Basic temperature logger driver
2023-08-06 TLV-14: Debug printf and transport layer
